elvtide01/7SegmentDice/docs/specification.md

# System Specification

## 1. Purpose

The purpose of this design is to implement an electronic dice as a small hierarchical digital circuit.
The system shall show a value between 1 and 6 on a 7-segment display.
The value shall change while a push button is pressed and shall continue to change with decreasing speed after the push button is released.

## 2. System Context

The design is intended for implementation as a synchronous digital circuit.
It uses one system clock, one reset input, one push-button input, two LED outputs and one single-digit 7-segment output.
The design is suitable for FPGA demonstration and for a small digital chip-design laboratory project.

## 3. External Interface

| Signal | Direction | Width | Polarity | Description |
|---|---:|---:|---|---|
| `CLK` (testbench port: `clk`) | Input | 1 | Rising edge | System clock input |
| `RST_N` (testbench port: `rst_n`) | Input | 1 | See note below | Reset input |
| `TRIGGER` | Input | 1 | Active high | Push-button input that starts or holds the fast counting phase |
| `LED1` | Output | 1 | Active low | Counting pulse indicator |
| `LED2` | Output | 1 | Active low | Finish-state indicator |
| `SEGA` | Output | 1 | Active low | 7-segment segment A |
| `SEGB` | Output | 1 | Active low | 7-segment segment B |
| `SEGC` | Output | 1 | Active low | 7-segment segment C |
| `SEGD` | Output | 1 | Active low | 7-segment segment D |
| `SEGE` | Output | 1 | Active low | 7-segment segment E |
| `SEGF` | Output | 1 | Active low | 7-segment segment F |
| `SEGG` | Output | 1 | Active low | 7-segment segment G |
| `SEGCOM` | Output | 1 | Constant 0 | Common 7-segment terminal control |

## 4. Functional Requirements
### REQ-001: Reset Behavior

After reset is applied and released, the system shall start in the finish/idle state, i.e. `finish_flag` shall be `1`, reflected by `LED2` being asserted (active-low, `LED2 = 0`).

Validation: [VAL-001](validation.md#val-001-reset-behavior)
Verification: [VER-001](verification-report.md#ver-001-reset-behavior)

### REQ-002: Dice Value Range

The system shall only display dice values from 1 to 6 during normal operation.

Validation: [VAL-002](validation.md#val-002-dice-value-range)
Verification: [VER-002](verification-report.md#ver-002-dice-value-range)

### REQ-003: Cyclic Dice Counting

The dice value shall increment by one on each accepted counting tick and shall wrap from 6 back to 1.

Validation: [VAL-003](validation.md#val-003-cyclic-dice-counting)
Verification: [VER-003](verification-report.md#ver-003-cyclic-dice-counting)

### REQ-004: Fast Counting While Trigger Is Pressed

While `TRIGGER` is high, the system shall count using the base counting period derived from `BASE_FREQ = 40 Hz`, and the displayed segment pattern shall visibly change and reach at least four distinct dice values within a bounded observation window.

Validation: [VAL-004](validation.md#val-004-fast-counting-while-trigger-is-pressed)
Verification: [VER-004](verification-report.md#ver-004-fast-counting-while-trigger-is-pressed)

### REQ-005: Deceleration After Trigger Release

After `TRIGGER` changes from high to low, the system shall increase the counting period once per second until the finish state is reached.

Validation: [VAL-005](validation.md#val-005-deceleration-after-trigger-release)
Verification: [VER-005](verification-report.md#ver-005-deceleration-after-trigger-release)

### REQ-006: Stop After Approximately Seven Seconds

After `TRIGGER` is released, the system shall enter the finish state after approximately seven seconds, after which the displayed segment pattern shall remain stable.

Validation: [VAL-006](validation.md#val-006-stop-after-approximately-seven-seconds)
Verification: [VER-006](verification-report.md#ver-006-stop-after-approximately-seven-seconds)

### REQ-007: Final Value Remains Constant

Once the finish state is reached after a `TRIGGER` release, the displayed segment pattern and `LED2` shall remain constant until the next trigger press.

Validation: [VAL-007](validation.md#val-007-final-value-remains-constant)
Verification: [VER-007](verification-report.md#ver-007-final-value-remains-constant)

### REQ-008: Counting Pulse LED

`LED1` shall indicate visible counting activity while the dice round is active (i.e. it shall become active at least once within a bounded number of clock cycles after `TRIGGER` is asserted).

Validation: [VAL-008](validation.md#val-008-counting-pulse-led)
Verification: [VER-008](verification-report.md#ver-008-counting-pulse-led)

### REQ-009: Finish LED

`LED2` shall be inactive (`LED2 = 1`, active-low) throughout the rolling/counting phase and shall change to active (`LED2 = 0`) only when the finish state is generated by the dice controller.

Validation: [VAL-009](validation.md#val-009-finish-led)
Verification: [VER-009](verification-report.md#ver-009-finish-led)

### REQ-010: 7-Segment Output Encoding

The system shall convert each dice value into a distinct 7-segment output pattern, such that at least four different valid patterns are observable while `TRIGGER` is held for a sufficiently long window.

Validation: [VAL-010](validation.md#val-010-7-segment-output-encoding)
Verification: [VER-010](verification-report.md#ver-010-7-segment-output-encoding)

### REQ-011: Hierarchical Design

The implementation shall consist of several interconnected Verilog submodules.

Validation: [VAL-011](validation.md#val-011-hierarchical-design)
Verification: [VER-011](verification-report.md#ver-011-hierarchical-design)

## 6. Timing Parameters

| Parameter | Value | Meaning |
|---|---:|---|
| `CLK_FREQ` | 12,000,000 Hz | System clock assumption |
| `BASE_FREQ` | 40 Hz | Initial count frequency |
| `BASE_PERIOD` | 300,000 cycles | Clock cycles per initial tick |
| `decay_level` range | 0 to 6 | Exponent for period multiplication |
| Finish delay | Approximately 7 s | Time from release to finish state |

The event period is calculated as:

```text
event_period = BASE_PERIOD << decay_level
```

Therefore, the intended tick periods are approximately:

| Decay Level | Event Period in Clock Cycles | Approx. Tick Period | Approx. Tick Frequency |
|---:|---:|---:|---:|
| 0 | 300,000 | 25 ms | 40 Hz |
| 1 | 600,000 | 50 ms | 20 Hz |
| 2 | 1,200,000 | 100 ms | 10 Hz |
| 3 | 2,400,000 | 200 ms | 5 Hz |
| 4 | 4,800,000 | 400 ms | 2.5 Hz |
| 5 | 9,600,000 | 800 ms | 1.25 Hz |
| 6 | 19,200,000 | 1.6 s | 0.625 Hz |

### 6.1 Testbench Timing Modes

`test.py` supports two simulation modes, selected via the `GATES` environment variable:

| Mode | `GATES` | `DISPLAY_WAIT` | `STATE_WAIT` | `STOP_WAIT` | `FINISH_WAIT` |
|---|---|---:|---:|---:|---:|
| RTL simulation | unset / not `"yes"` | 200 cycles | 300 cycles | 5,000 cycles | 300 cycles |
| Gate-level simulation | `"yes"` | 300,000 cycles | 1,200,000 cycles | 7,500,000 cycles | 6,000,000 cycles |

The gate-level values are scaled to be consistent with the real cycle counts implied by `BASE_PERIOD` and the ~7 s finish delay; the RTL-mode values are deliberately shortened so RTL simulations run quickly and are **behavioral bounds only** (e.g. "a change must occur within N cycles"), not precise timing checks of `BASE_FREQ` or the 7-second finish delay.

## 7. Non-Functional Requirements

### REQ-012: Simplicity

The design shall remain small enough for a laboratory chip-design project and shall avoid unnecessary overengineering.

Validation: [VAL-012](validation.md#val-012-simplicity)
Verification: [VER-012](verification-report.md#ver-012-simplicity)

### REQ-013: Testability

The top-level design shall be testable by a Verilog testbench or by an equivalent HDL simulation method, and shall support both RTL and gate-level simulation.

Validation: [VAL-013](validation.md#val-013-testability)
Verification: [VER-013](verification-report.md#ver-013-testability)

## 8. Known Specification Boundaries

The current specification does not require cryptographic randomness.
The dice behavior is pseudo-random from a user perspective because the visible final value depends on the release timing of the push button.
The current specification also does not require hardware debouncing
