elvtide01/7SegmentDice/docs/images/hardware_sketch.png

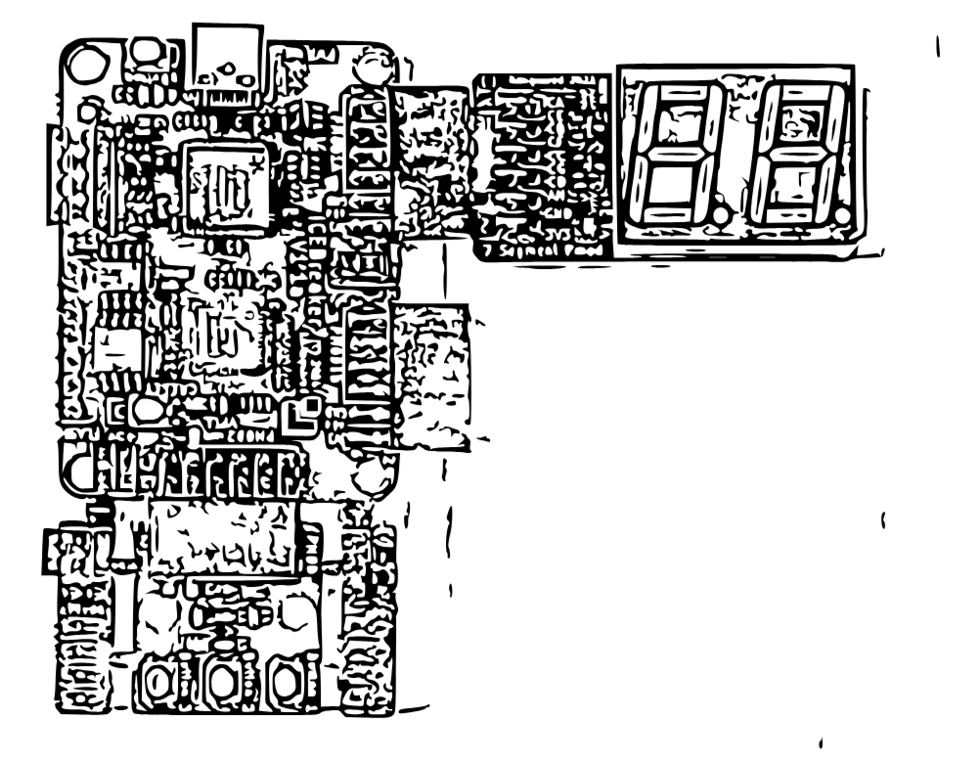
docs/images/hardware_sketch.png
