elvtide01/7SegmentDice/docs/images/SimulationFull.PNG

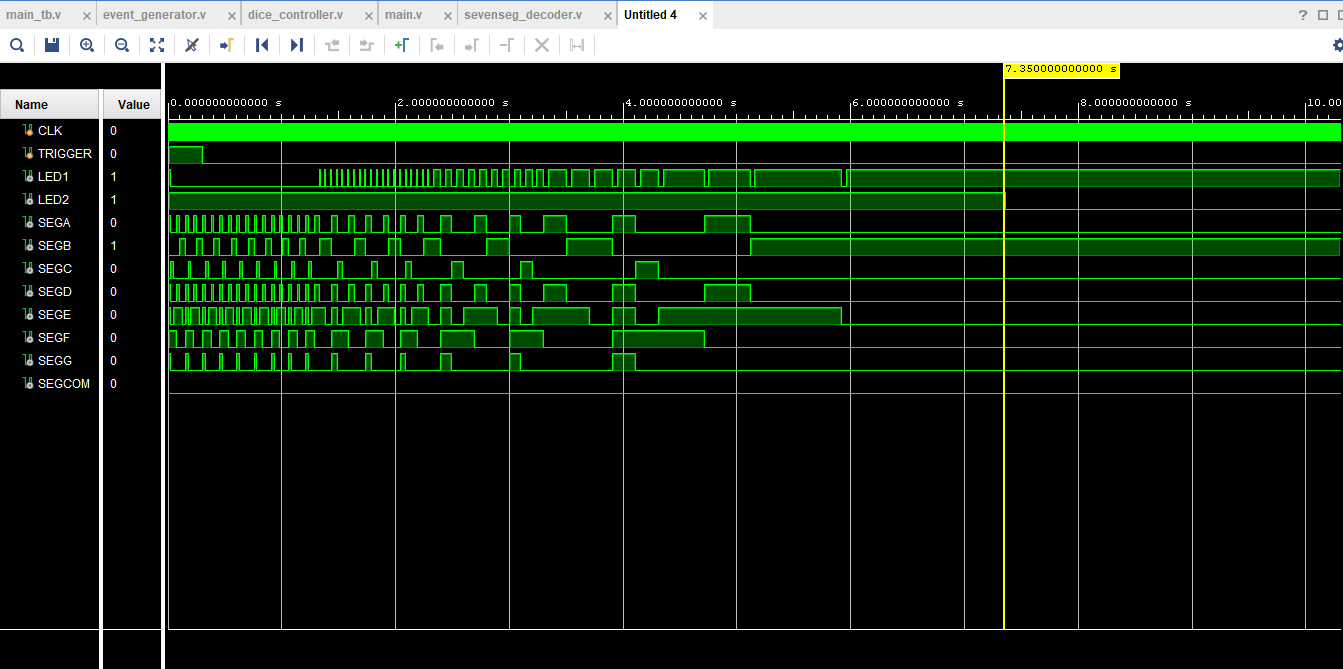
docs/images/SimulationFull.PNG
