elvtide01/7SegmentDice/docs/images/SimulationStart.PNG

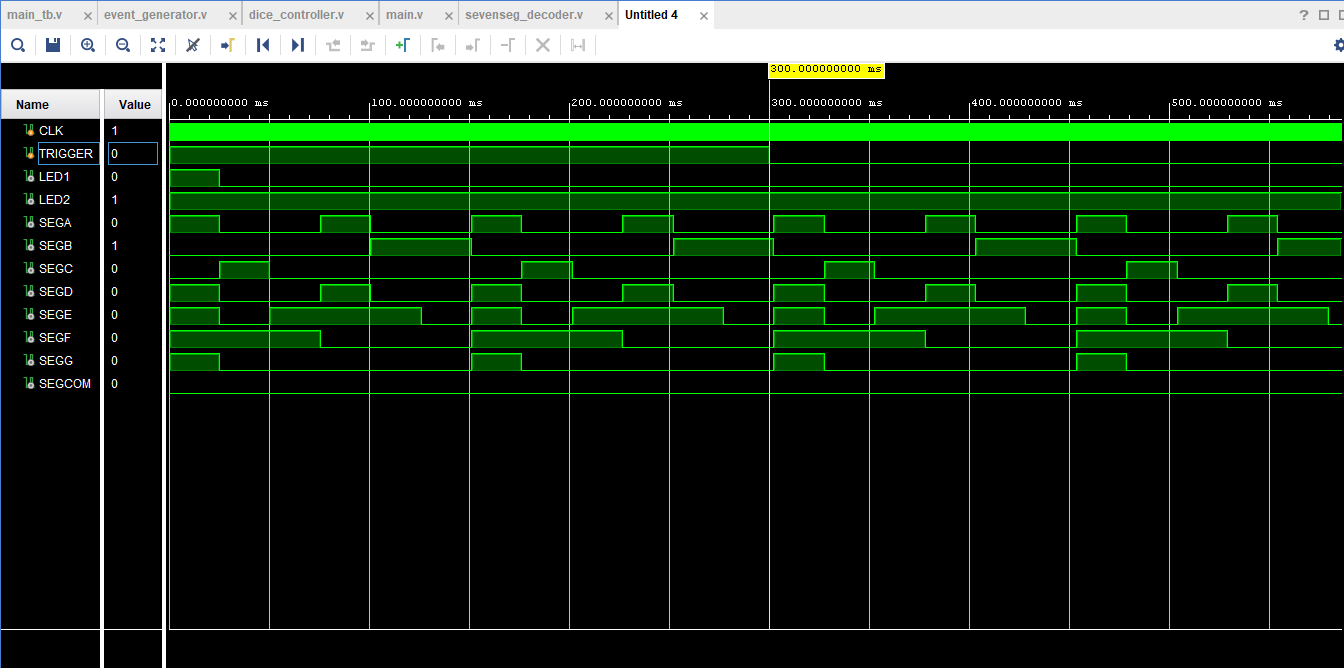
docs/images/SimulationStart.PNG
