elvtide01/7SegmentDice/(commit log)

2026-06-19 Fix casing for DUT signals in test.py
    [test.py]
2026-06-19 Change reset signal from rst to rst_n
    [test.py]
2026-06-19 Add trigger register and ui_in wire definition
    Added trigger register and updated ui_in wire.
2026-06-19 Fix binary literal syntax for ui_in assignment
    [tb.v]
2026-06-19 Rename wire signals for consistency and clarity
2026-06-19 Add reset signal to dice instance
    [tt_um_elvtide01_7SegmentDice.v]
2026-06-19 Change wire names to lowercase for consistency
2026-06-19 Rename segment wires to uppercase
2026-06-19 Fix reset signal logic in reset_dut function
    Reversed the reset signal logic in the reset_dut function.
    [test.py]
2026-06-19 Fix reset signal values in reset_dut function
    [test.py]
2026-06-19 Clean up unused wires in 7SegmentDice module
    Removed unused wires and assignments for clarity.
2026-06-19 Invert reset signal in 7SegmentDice module
    [tt_um_elvtide01_7SegmentDice.v]
2026-06-19 Fix reset signal assignment in 7SegmentDice module
    [tt_um_elvtide01_7SegmentDice.v]
2026-06-19 Print GATE and GL environment variables
    Added environment variable printing for GATE and GL.
2026-06-19 Simplify environment variable printout
    Removed conditional check for GATE and GL in environment variable printout.
2026-06-20 Print wait constants in test.py
    Add print statements for wait constants
2026-07-24 Update pin assignments in icebreaker.pcf
